htynhi-vivian/may-doc-the-7a/hinh/h3_lap_mach_that.png

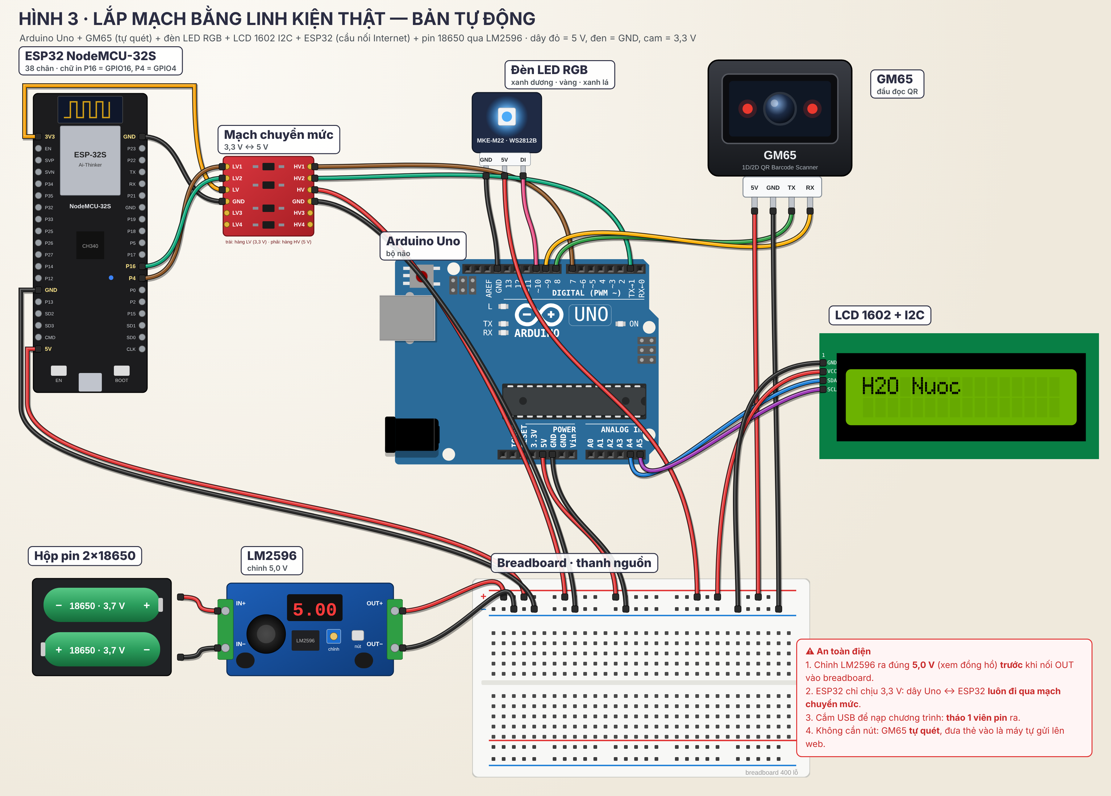
hinh/h3_lap_mach_that.png
