htynhi-vivian/may-doc-the-7a/firebase_web/anh_ca_lop.png

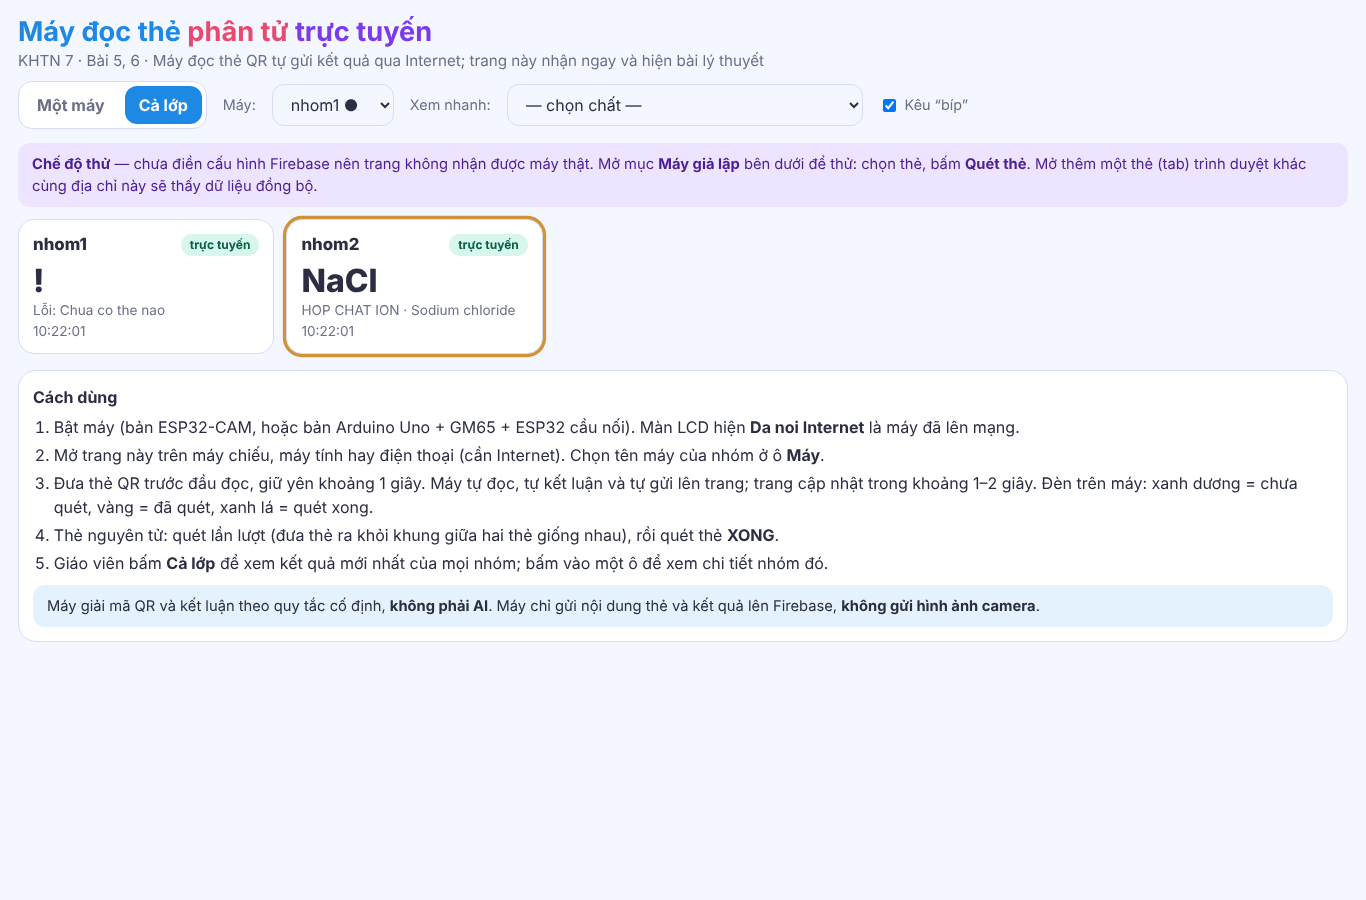
firebase_web/anh_ca_lop.png
