htynhi-vivian/may-doc-the-7a/firebase_web/anh_mot_may.png

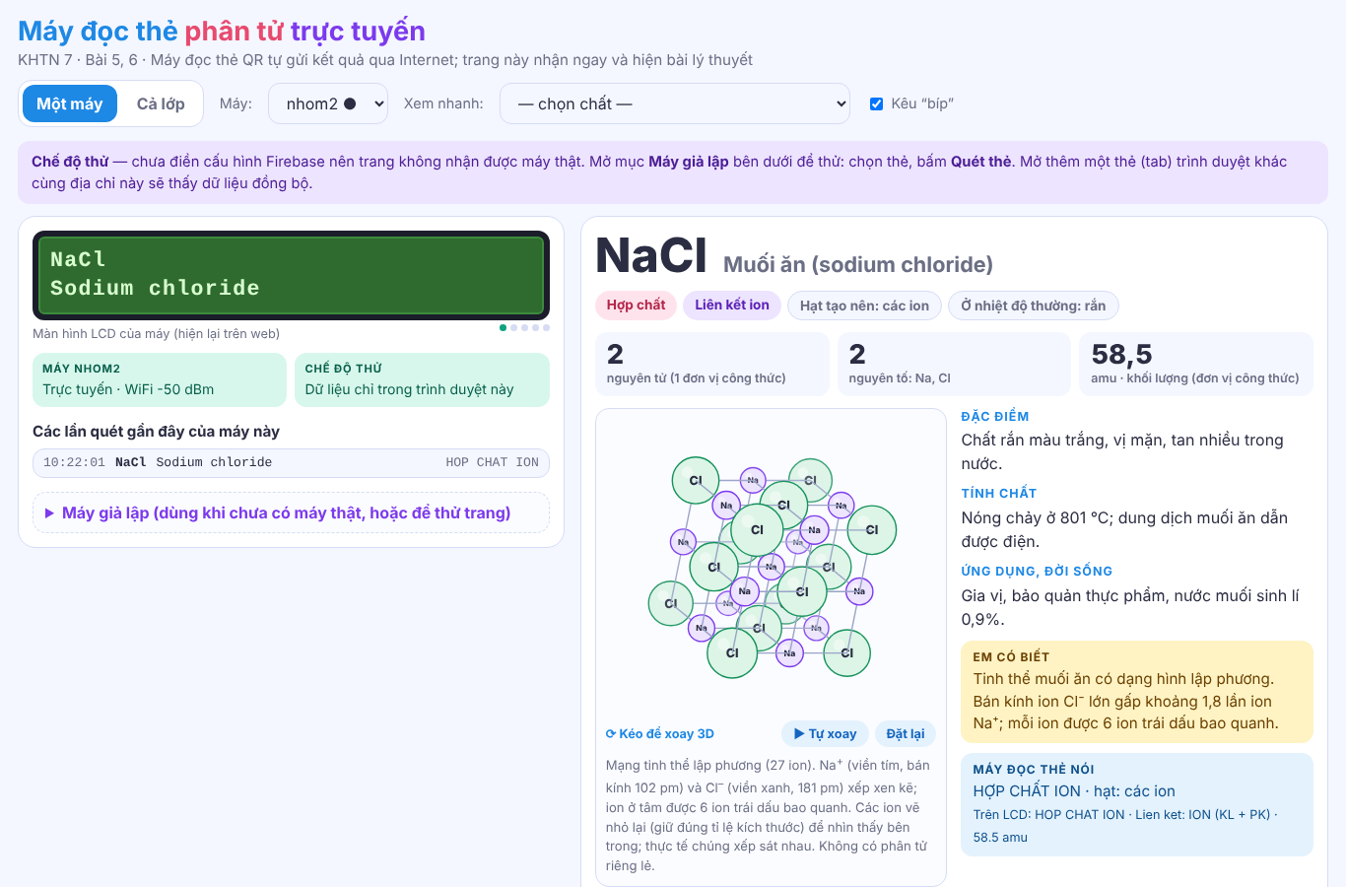
firebase_web/anh_mot_may.png
