htynhi-vivian/may-doc-the-7a/hinh/h1_so_do_khoi.png

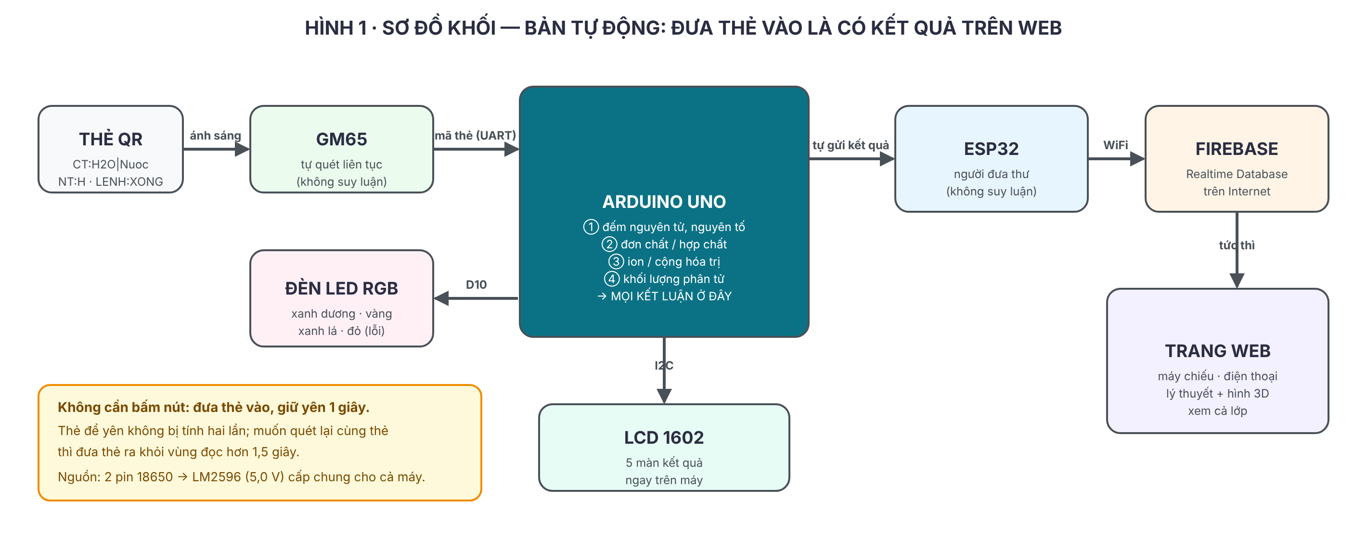
hinh/h1_so_do_khoi.png
