htynhi-vivian/may-doc-the-7a/hinh/h2_so_do_noi_day.png

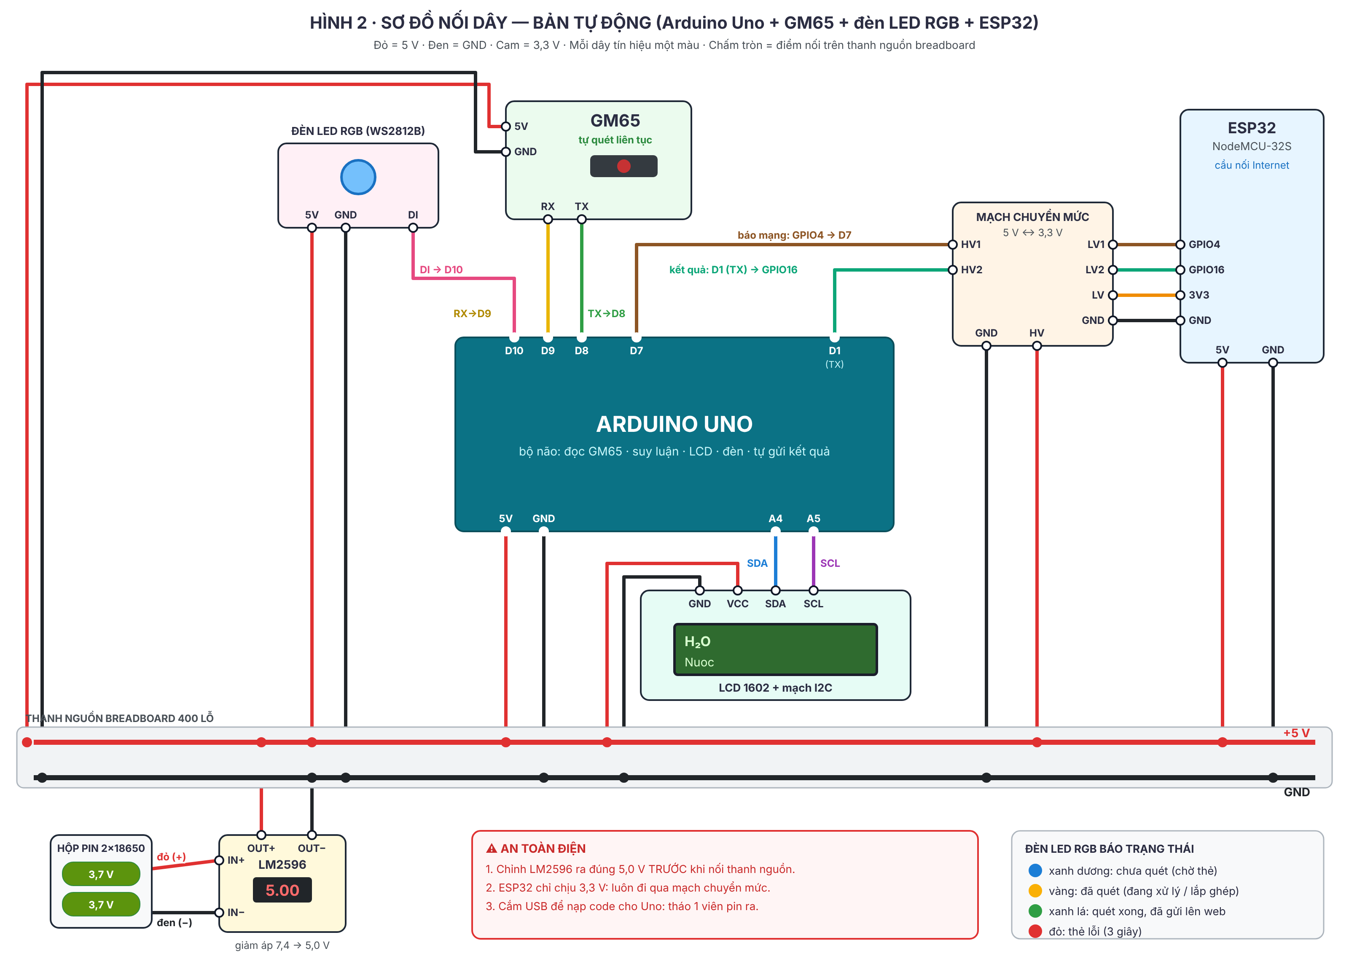
hinh/h2_so_do_noi_day.png
