htynhi-vivian/may-doc-the-7a/hinh/h4_noi_day_chuyen_muc.png

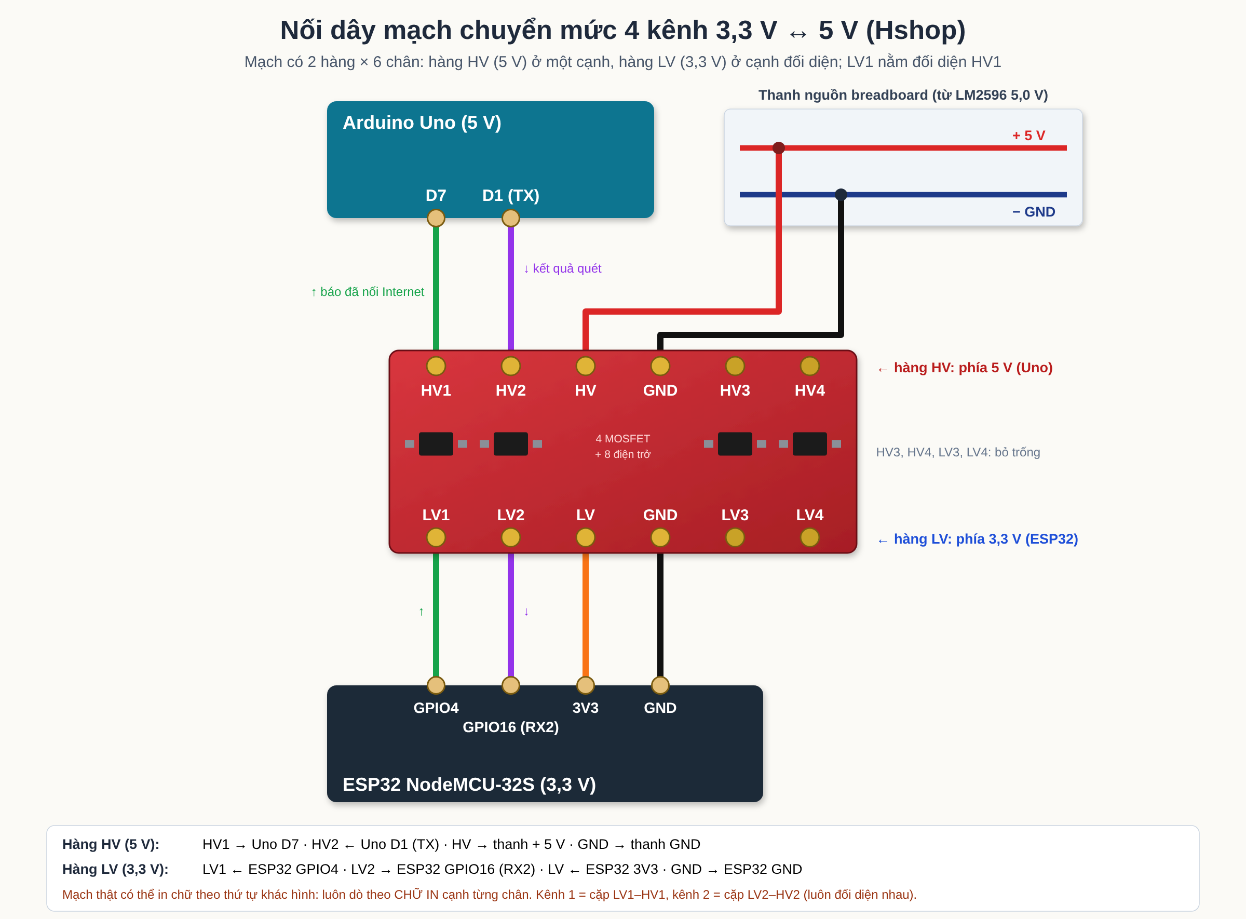
hinh/h4_noi_day_chuyen_muc.png
