htynhi-vivian/may-doc-the-7a/hinh/h5_noi_day_esp32.png

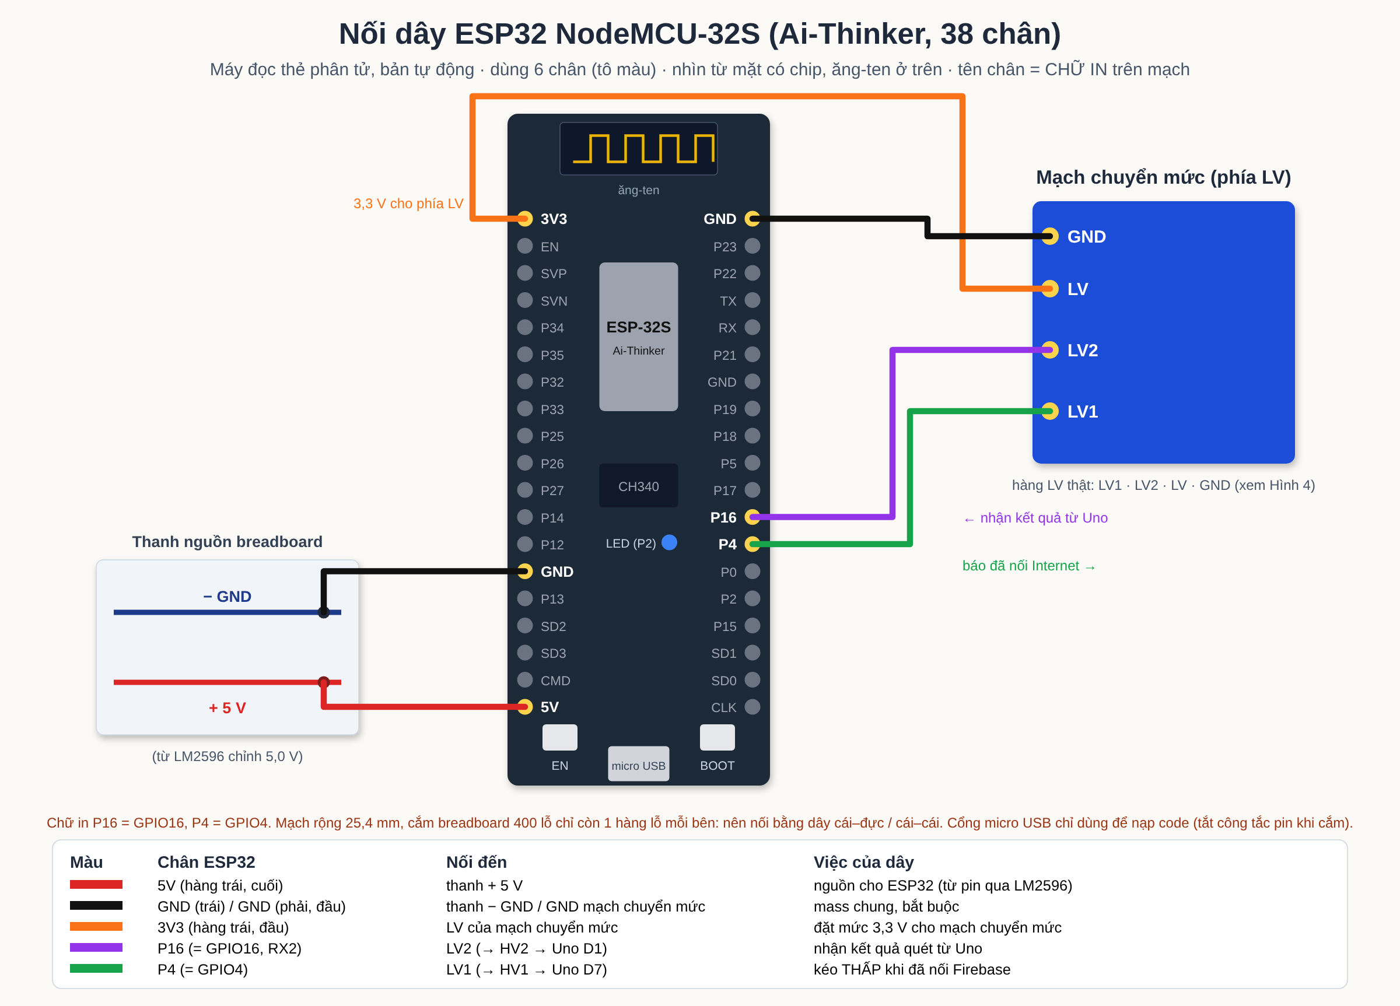
hinh/h5_noi_day_esp32.png
