htynhi-vivian/may-doc-the-7a/Bo_the_QR_KHTN7_Bai5_Bai6.pdf

## BỘ THẺ QR — KHTN 7, BÀI 5 + BÀI 6 (mỗi chất 1 thẻ)

# Al2O3

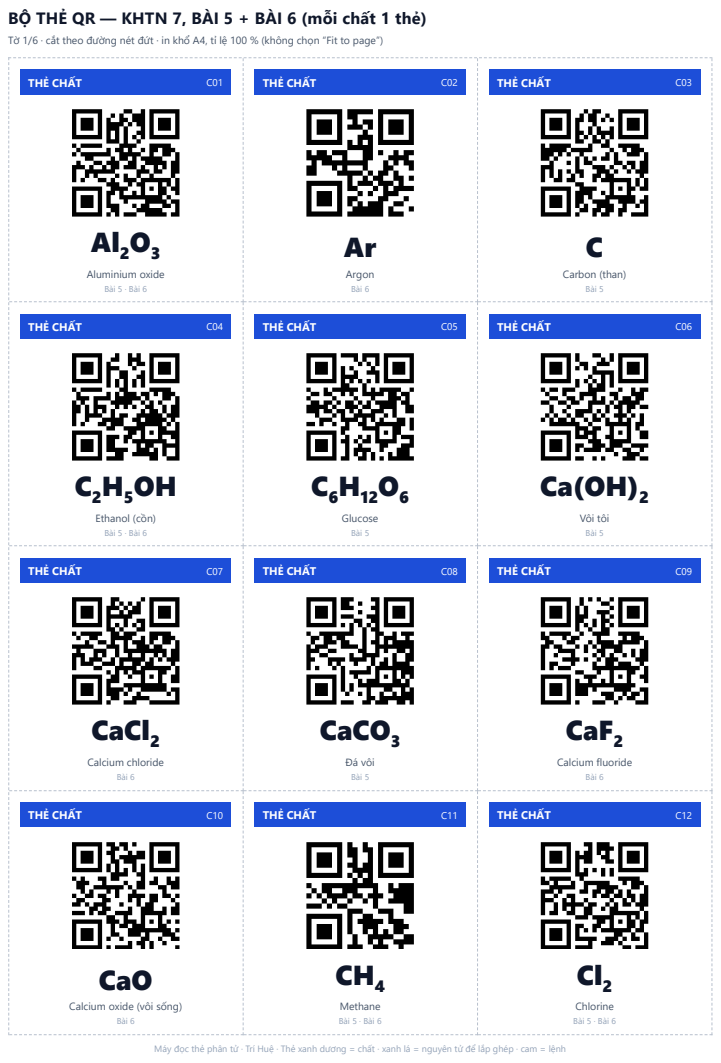
[picture p8: page 1]

Tờ 1/6 · cắt theo đường nét đứt · in khổ A4, tỉ lệ 100 % (không chọn “Fit to page”)

Calcium oxide (vôi sống)

Máy đọc thẻ phân tử · Trí Huệ · Thẻ xanh dương = chất · xanh lá = nguyên tử để lắp ghép · cam = lệnh

CO

Co

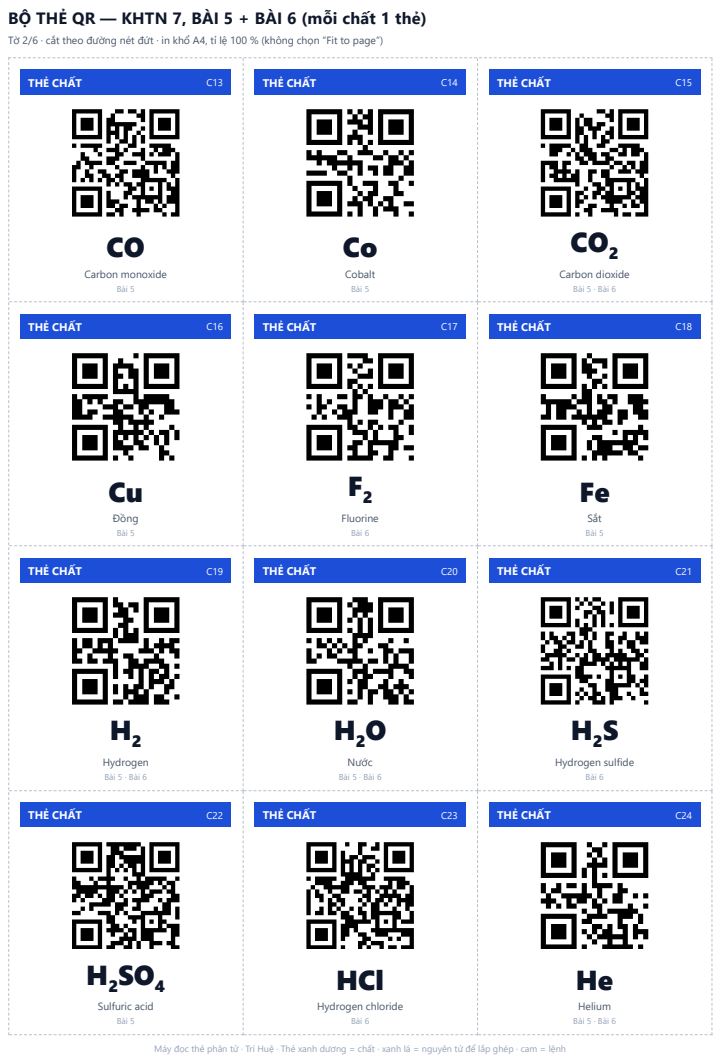
[picture p9: page 2]

Tờ 2/6 · cắt theo đường nét đứt · in khổ A4, tỉ lệ 100 % (không chọn “Fit to page”)

K2O

# KBr

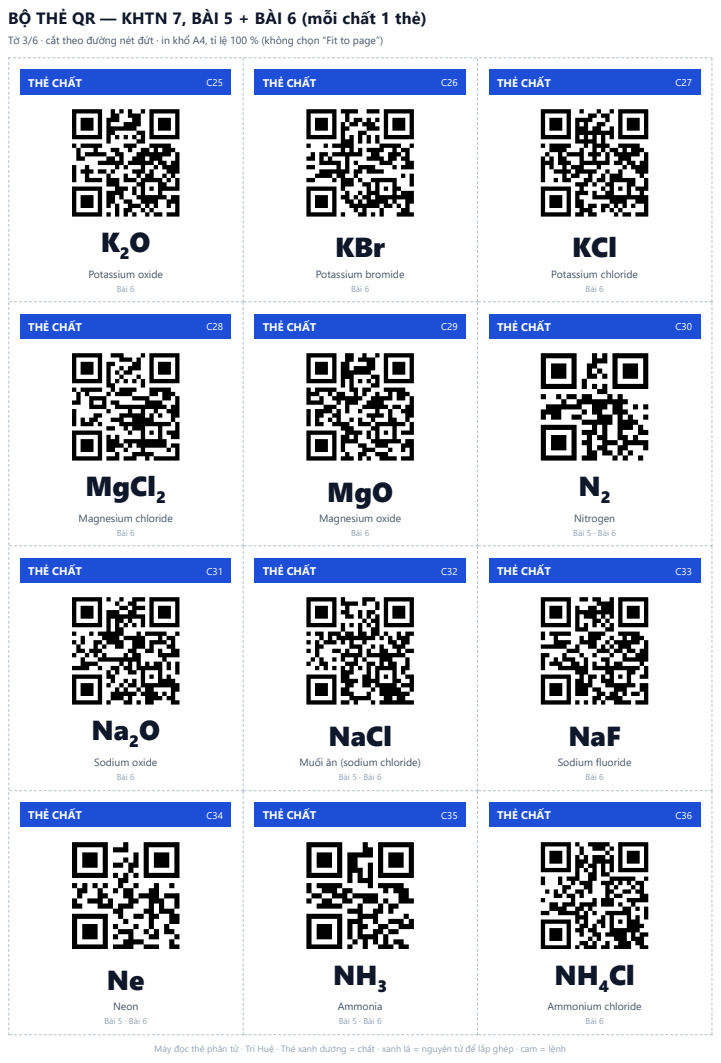
[picture p10: page 3]

Tờ 3/6 · cắt theo đường nét đứt · in khổ A4, tỉ lệ 100 % (không chọn “Fit to page”)

Muối ăn (sodium chloride)

# (NH4)2SO4

O2

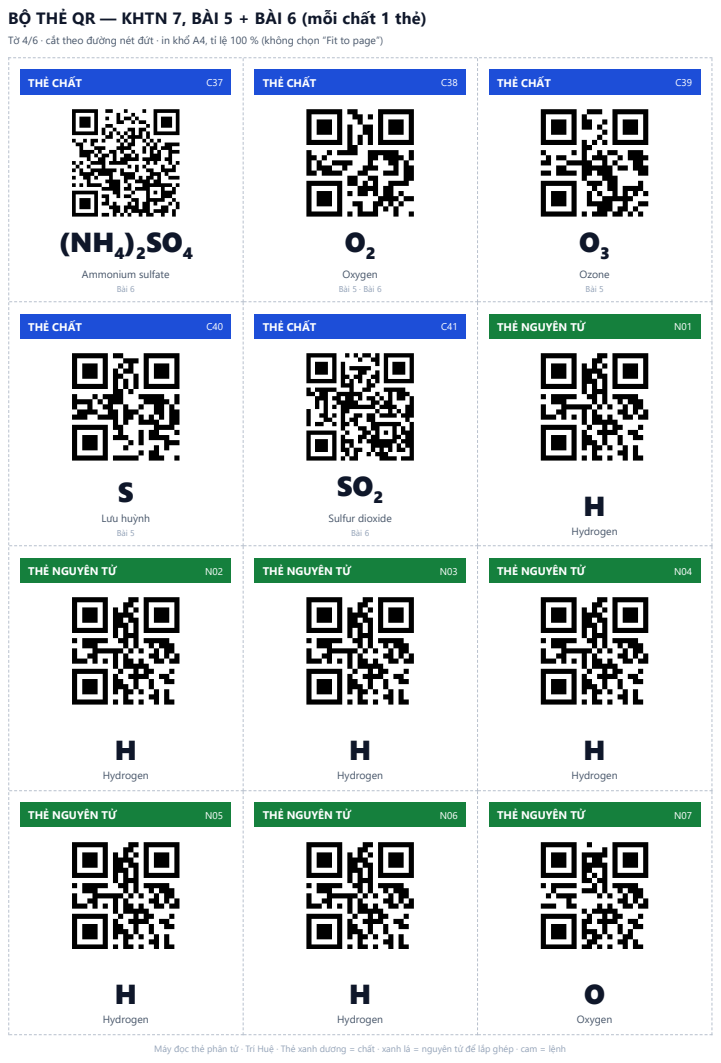
[picture p11: page 4]
THẺ CHẤT; Ammonium sulfate; Bài 6; Oxygen; Bài 5 · Bài 6; Ozone; Bài 5; Lưu huỳnh; Sulfur dioxide; THẺ NGUYÊN TỬ; Hydrogen

Tờ 4/6 · cắt theo đường nét đứt · in khổ A4, tỉ lệ 100 % (không chọn “Fit to page”)

O

O

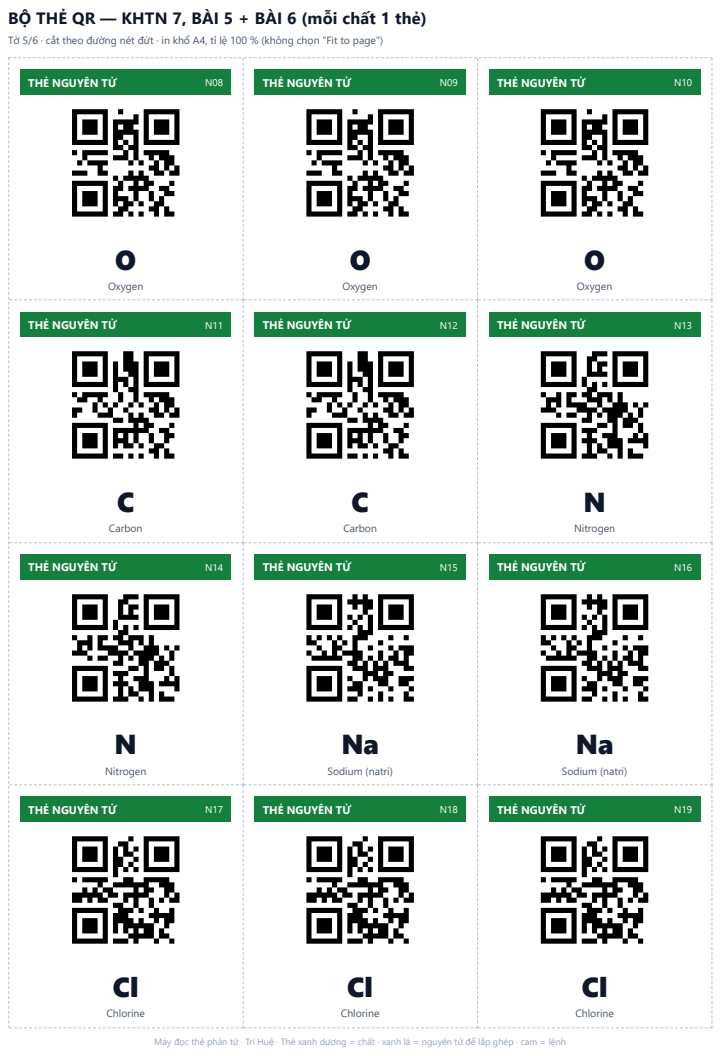
[picture p12: page 5]
THẺ NGUYÊN TỬ; Oxygen; Carbon; Nitrogen; Sodium (natri); Chlorine

Tờ 5/6 · cắt theo đường nét đứt · in khổ A4, tỉ lệ 100 % (không chọn “Fit to page”)

S

S

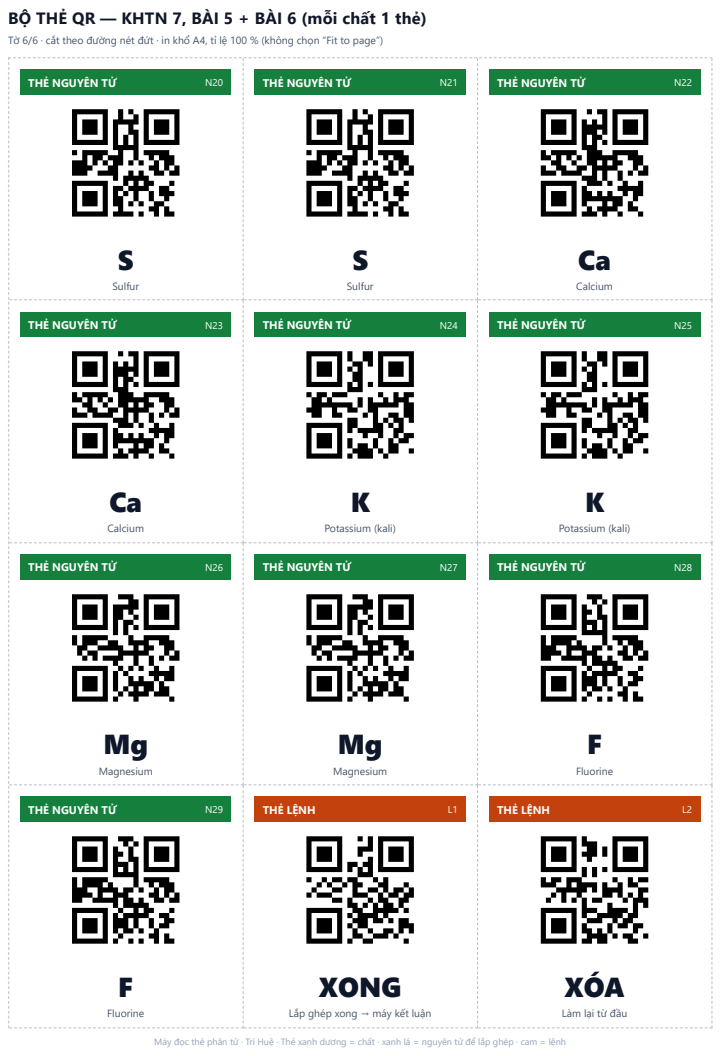
[picture p13: page 6]
THẺ NGUYÊN TỬ; Sulfur; Calcium; Potassium (kali); Magnesium; Fluorine; THẺ LỆNH; XONG; XÓA

Tờ 6/6 · cắt theo đường nét đứt · in khổ A4, tỉ lệ 100 % (không chọn “Fit to page”)

Lắp ghép xong → máy kết luận

Làm lại từ đầu

## ĐÁP ÁN CHO GIÁO VIÊN — máy kết luận gì với từng thẻ chất

Tính theo đúng quy tắc của may_doc_the_internet.ino. Không phát tờ này cho học sinh. Cột “Bài 5” là dòng kết luận trên LCD, cột “Bài 6” là màn hình liên kết.

Thẻ | Công thức | Tên | Bài | Ng.tử | Ng.tố | Bài 5 (LCD) | Bài 6 (LCD) | Hạt | KLPT
C01 | Al2O3 | Aluminium oxide | 5, 6 | 5 | 2 | HOP CHAT ION | ION (KL + PK) | Các ion | 102.0
C02 Ar | Argon | 6 | 1 | 1 | DON CHAT | Đơn chất KHÍ HIẾM | Nguyên tử | 40.0
C03 | C | Carbon (than) | 5 | 1 | 1 | DON CHAT | Đơn chất PHI KIM | Nguyên tử | 12.0
C04 C2H5OH | Ethanol (cồn) | 5, 6 9 | 3 | HOP CHAT | CỘNG HÓA TRỊ | Phân tử | 46.0
C05 | C6H12O6 | Glucose | 5 | 24 | 3 | HOP CHAT | CỘNG HÓA TRỊ | Phân tử | 180.0
C06 Ca(OH)2 | Vôi tôi | 5 | 5 | 3 | HOP CHAT ION | ION (KL + PK) | Các ion | 74.0
C07 | CaCl2 | Calcium chloride | 6 | 3 | 2 | HOP CHAT ION | ION (KL + PK) | Các ion | 111.0
C08 CaCO3 | Đá vôi | 5 | 5 | 3 | HOP CHAT ION | ION (KL + PK) | Các ion | 100.0
C09 | CaF2 | Calcium fluoride | 6 | 3 | 2 | HOP CHAT ION | ION (KL + PK) | Các ion | 78.0
C10 CaO | Calcium oxide (vôi sống) | 6 | 2 | 2 | HOP CHAT ION | ION (KL + PK) | Các ion | 56.0
C11 | CH4 | Methane | 5, 6 | 5 | 2 | HOP CHAT | CỘNG HÓA TRỊ | Phân tử | 16.0
C12 Cl2 | Chlorine | 5, 6 2 | 1 | DON CHAT | Đơn chất PHI KIM | Phân tử | 71.0
C13 | CO | Carbon monoxide | 5 | 2 | 2 | HOP CHAT | CỘNG HÓA TRỊ | Phân tử | 28.0
C14 Co | Cobalt | 5 | 1 | 1 | DON CHAT | Đơn chất KIM LOẠI | Nguyên tử | 59.0
C15 | CO2 | Carbon dioxide | 5, 6 | 3 | 2 | HOP CHAT | CỘNG HÓA TRỊ | Phân tử | 44.0
C16 Cu | Đồng | 5 | 1 | 1 | DON CHAT | Đơn chất KIM LOẠI | Nguyên tử | 64.0
C17 | F2 | Fluorine | 6 | 2 | 1 | DON CHAT | Đơn chất PHI KIM | Phân tử | 38.0
C18 Fe | Sắt | 5 | 1 | 1 | DON CHAT | Đơn chất KIM LOẠI | Nguyên tử | 56.0
C19 | H2 | Hydrogen | 5, 6 | 2 | 1 | DON CHAT | Đơn chất PHI KIM | Phân tử | 2.0
C20 H2O | Nước | 5, 6 3 | 2 | HOP CHAT | CỘNG HÓA TRỊ | Phân tử | 18.0
C21 | H2S | Hydrogen sulfide | 6 | 3 | 2 | HOP CHAT | CỘNG HÓA TRỊ | Phân tử | 34.0
C22 H2SO4 | Sulfuric acid | 5 | 7 | 3 | HOP CHAT | CỘNG HÓA TRỊ | Phân tử | 98.0
C23 | HCl | Hydrogen chloride | 6 | 2 | 2 | HOP CHAT | CỘNG HÓA TRỊ | Phân tử | 36.5
C24 He | Helium | 5, 6 1 | 1 | DON CHAT | Đơn chất KHÍ HIẾM | Nguyên tử | 4.0
C25 | K2O | Potassium oxide | 6 | 3 | 2 | HOP CHAT ION | ION (KL + PK) | Các ion | 94.0
C26 KBr | Potassium bromide | 6 | 2 | 2 | HOP CHAT ION | ION (KL + PK) | Các ion | 119.0
C27 | KCl | Potassium chloride | 6 | 2 | 2 | HOP CHAT ION | ION (KL + PK) | Các ion | 74.5
C28 MgCl2 | Magnesium chloride | 6 | 3 | 2 | HOP CHAT ION | ION (KL + PK) | Các ion | 95.0
C29 | MgO | Magnesium oxide | 6 | 2 | 2 | HOP CHAT ION | ION (KL + PK) | Các ion | 40.0
C30 N2 | Nitrogen | 5, 6 2 | 1 | DON CHAT | Đơn chất PHI KIM | Phân tử | 28.0
C31 | Na2O | Sodium oxide | 6 | 3 | 2 | HOP CHAT ION | ION (KL + PK) | Các ion | 62.0
C32 NaCl | Muối ăn (sodium chloride) | 5, 6 2 | 2 | HOP CHAT ION | ION (KL + PK) | Các ion | 58.5
C33 | NaF | Sodium fluoride | 6 | 2 | 2 | HOP CHAT ION | ION (KL + PK) | Các ion | 42.0
C34 Ne | Neon | 5, 6 1 | 1 | DON CHAT | Đơn chất KHÍ HIẾM | Nguyên tử | 20.0
C35 | NH3 | Ammonia | 5, 6 | 4 | 2 | HOP CHAT | CỘNG HÓA TRỊ | Phân tử | 17.0
C36 | NH4Cl | Ammonium chloride | 6 | 6 | 3 | HOP CHAT | CỘNG HÓA TRỊ → máy SAI | Phân tử | 53.5
C37 | (NH4 )2SO4 | Ammonium sulfate | 6 | 15 | 4 | HOP CHAT | CỘNG HÓA TRỊ → máy SAI | Phân tử | 132.0
C38 O2 | Oxygen | 5, 6 2 | 1 | DON CHAT | Đơn chất PHI KIM | Phân tử | 32.0
C39 | O3 | Ozone | 5 | 3 | 1 | DON CHAT | Đơn chất PHI KIM | Phân tử | 48.0
C40 S | Lưu huỳnh | 5 | 1 | 1 | DON CHAT | Đơn chất PHI KIM | Nguyên tử | 32.0
C41 | SO2 | Sulfur dioxide | 6 | 3 | 2 | HOP CHAT | CỘNG HÓA TRỊ | Phân tử | 64.0

## Lắp ghép bằng thẻ nguyên tử (quét từng thẻ, rồi quét thẻ XONG)

H, H, O → H₂O · HOP CHAT
C, O, O → CO₂ · HOP CHAT
O, O → O₂ · DON CHAT
N, H, H, H → NH₃ · HOP CHAT C, H, H, H, H → CH₄ · HOP CHAT Na, Cl → NaCl · ION (KL + PK) Ca, O → CaO · ION (KL + PK)

Mg, O → MgO · ION (KL + PK) K, Cl → KCl · ION (KL + PK)
H, Cl → HCl · CỘNG HÓA TRỊ
Cl, Cl → Cl₂ · đơn chất PHI KIM
Na, F → NaF · ION (KL + PK)
N, H, H, H, H, Cl (thử thách) → NH₄Cl
H, O (bẫy) → HO: máy vẫn đếm, nhưng HO không phải chất bền

## Ghi chú dạy học

Mỗi công thức chỉ có một thẻ (C01–C41), xếp theo thứ tự chữ cái để học sinh không đoán được nhóm. Dòng nhỏ dưới tên cho biết thẻ dùng ở Bài 5, Bài 6 hay cả hai.
Cặp dễ nhầm: O₂/O₃ (cùng nguyên tố, khác số nguyên tử, đều là đơn chất); Co/CO (chữ thường/hoa: kim loại cobalt và khí carbon monoxide).
NaCl, CaCO₃, Ca(OH)₂, Al₂O₃: Bài 5 chỉ cần kết luận HỢP CHẤT; máy báo “hạt là các ion” là nội dung Bài 6.
Hai thẻ thử thách NH₄Cl và (NH₄)₂SO₄ (tô hồng): không có kim loại nên máy nói CỘNG HÓA TRỊ, nhưng thực tế có ion NH₄⁺ liên kết ion với Cl⁻ / SO₄²⁻. Cho học sinh tìm vì sao máy sai.
Thẻ nguyên tử có nhiều bản (6 H, 4 O, 3 Cl…) để ghép CH₄, NH₄Cl. Hai thẻ giống nhau liên tiếp: rút thẻ ra hơn 1,5 giây rồi quét tiếp.
Thẻ cam: XONG = máy kết luận chất vừa lắp ghép; XÓA = làm lại. Đèn: xanh dương chờ · vàng đang đọc / lắp ghép · xanh lá quét xong (3 giây) · đỏ lỗi.
