htynhi-vivian/may-doc-the-7a/(commit log)

2026-10-27 Máy đọc thẻ phân tử KHTN 7: bản tự động Uno + GM65 + LED RGB + ESP32 + Firebase
    - Firmware Arduino Uno (GM65 tự quét, chống gửi trùng, đèn WS2812B 3 trạng thái)
    - Cầu nối ESP32 NodeMCU-32S gửi kết quả lên Firebase Realtime Database
    - Trang web lớp học Firebase Hosting + quy tắc dữ liệu
    - Bản nạp sẵn cho nhom1, nhom2 (dự án may-doc-the-7a-a2195)
    - Kiểm thử giả lập + simavr, sơ đồ nối dây, đơn hàng Hshop, hướng dẫn
    Claude-Session: https://claude.ai/code/session_01H3fjcgHgb7hsawkKt68WHA
    [Don_bo_sung_Hshop_27-10-2026.xlsx, Don_hang_Hshop_02_bo_Uno_GM65_Tu_dong.xlsx]
2026-10-27 Chuyển sang dự án Firebase may-doc-the-7a
    Web app trang-web-lop, Realtime Database asia-southeast1 mới; cập nhật
    apiKey, databaseURL ở trang web và 3 bản cau_hinh.h của ESP32; tài liệu.
    Claude-Session: https://claude.ai/code/session_01RccX4BpWnAE814Wt91qFpD
2026-10-27 Cài WiFi và kiểm tra mạch qua cáp USB từ trang web
    - Trang web: tab "Cài đặt mạch (USB)" (Web Serial): nhận ra ESP32/Uno,
    dò WiFi, lưu mật khẩu, đổi tên máy, xem Serial Monitor
    - ESP32 1.2: lệnh #INFO/#QUET/#WIFI/#MAY; WiFi và tên máy lưu NVS,
    báo sai mật khẩu / không thấy mạng
    - Uno: trả lời #INFO để trang nhận ra mạch
    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
2026-10-28 Chỉ còn một bộ thiết bị: bỏ nhóm 1/nhóm 2
    - Bỏ nap_san_nhom1, nap_san_nhom2; ESP32 dùng một bản cau_noi_internet,
    tên máy cố định MAY_ID = may7a, bỏ lệnh #MAY
    - Trang web: bỏ tab Cả lớp, ô chọn máy, ô tên máy của máy giả lập và
    phần đổi tên máy; tab chính đổi tên thành "Kết quả quét"
    - Cập nhật README và hướng dẫn: cài WiFi từ trang web
    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
2026-10-29 Trang in thẻ QR: 42 thẻ chất, 33 thẻ nguyên tử, thẻ XONG/XÓA
    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
2026-10-29 Uno tự đặt GM65 xuất mã qua cổng nối tiếp (không phải bàn phím USB)
    GM65 ở chế độ bàn phím USB kêu bíp khi quét nhưng không gửi gì sang chân D8.
    Khi khởi động, Uno đọc ô 0x000D và đặt 2 bit thấp về 00 nếu cần, rồi lưu.
    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
2026-10-29 Đèn LED dùng thư viện Adafruit NeoPixel (mã máy tự viết không làm đèn sáng)
    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
2026-10-29 GM65 chuyển sang chế độ cảm ứng (đèn chiếu chỉ bật khi có thẻ)
    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
2026-10-29 Đèn: giữ thứ tự G-R-B, vàng tươi hơn, xanh lá 3 giây rồi về xanh dương
    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
2026-10-29 Giao diện mới cho học sinh THCS: tab Khám phá và tab Dành cho thầy cô
    Chữ to, màu tươi, bước hướng dẫn khi chưa quét, bấm lần quét cũ để xem lại,
    nút Phóng to để chiếu cả lớp. Kiểm tra mạch, cài WiFi, máy giả lập chuyển sang tab thầy cô.
    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
2026-10-29 Bộ thẻ QR gộp Bài 5 + Bài 6: mỗi chất 1 thẻ, thêm bài học CaF2
    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
2026-10-29 Thêm file PDF bộ thẻ QR gộp Bài 5 + Bài 6 (mỗi chất 1 thẻ, kèm đáp án)
    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
